namor5772/Altimeter/Images/Adaptor.png

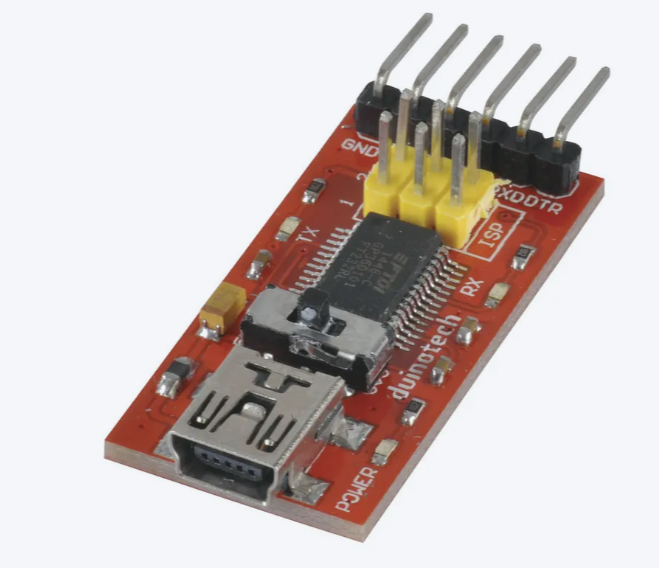
Images/Adaptor.png
