namor5772/Altimeter/Images/Case.png

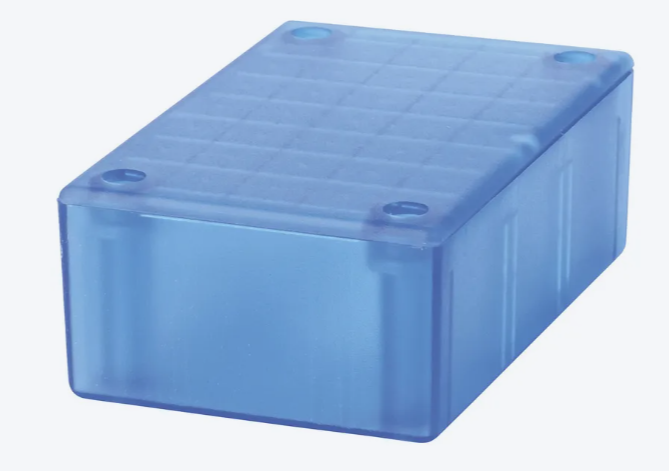
Images/Case.png
