namor5772/Altimeter/Images/Charger.png

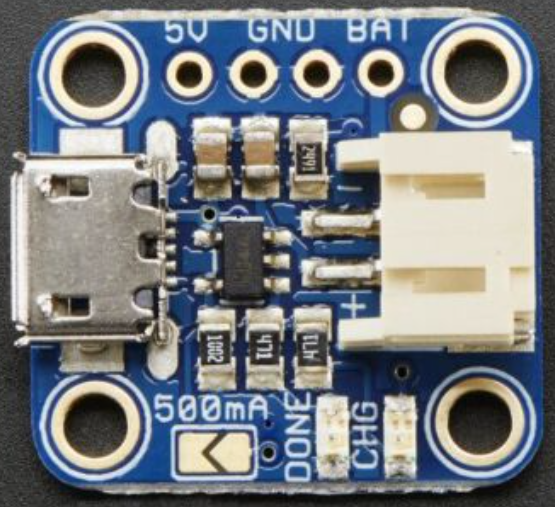
Images/Charger.png
