namor5772/Altimeter/Images/CopperWire.png

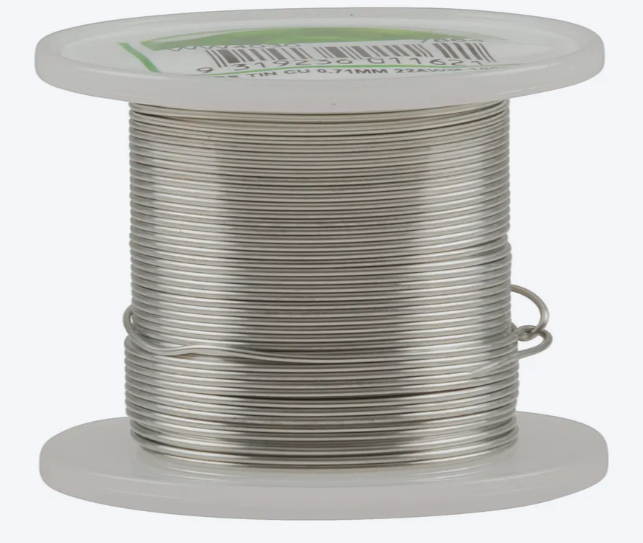
Images/CopperWire.png
