namor5772/Altimeter/Images/Display.png

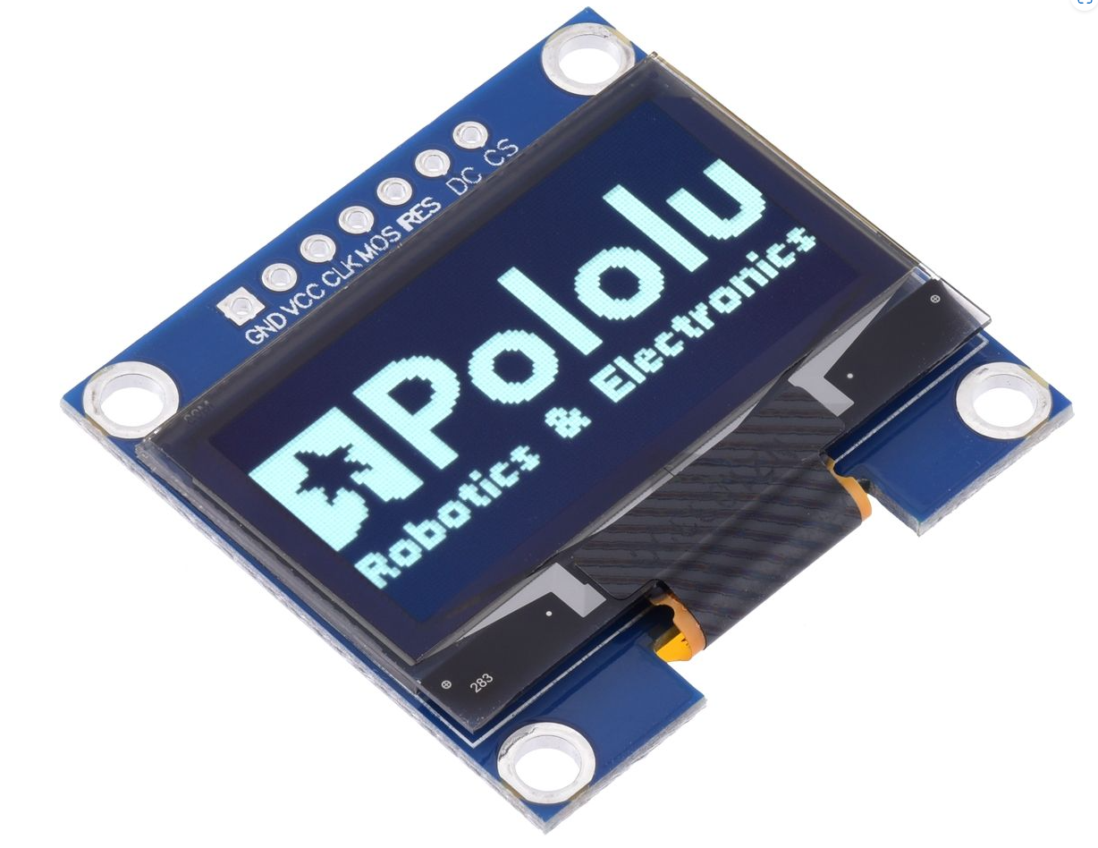
Images/Display.png
