namor5772/Altimeter/Images/FemaleStrip.png

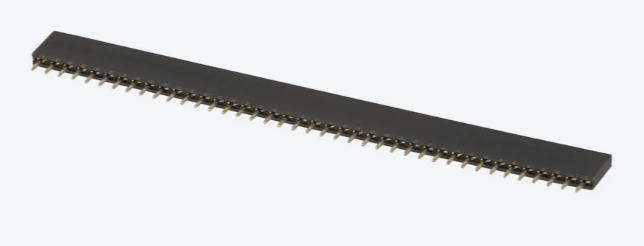
Images/FemaleStrip.png
