namor5772/Altimeter/Images/FuelGauge.png

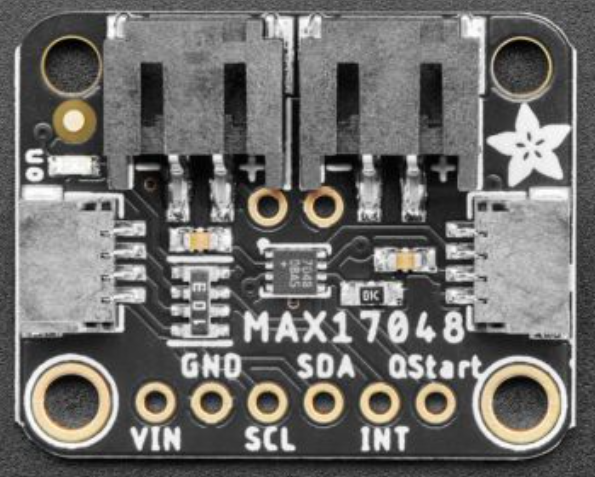
Images/FuelGauge.png
