namor5772/Altimeter/Images/image-6.png

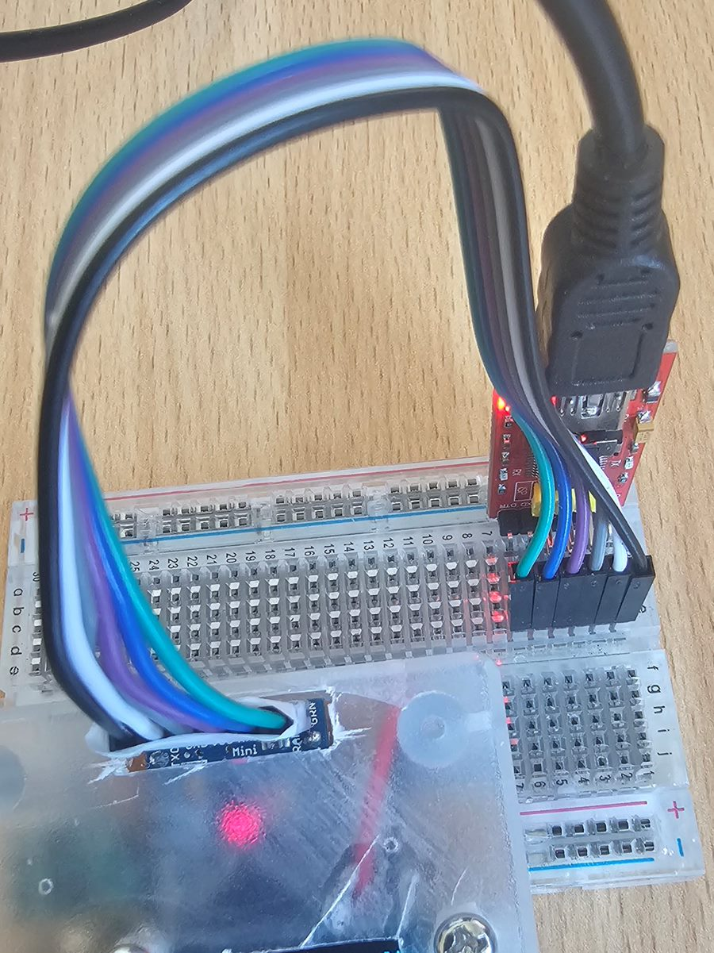
Images/image-6.png
