namor5772/Altimeter/Images/LiPoBattery.png

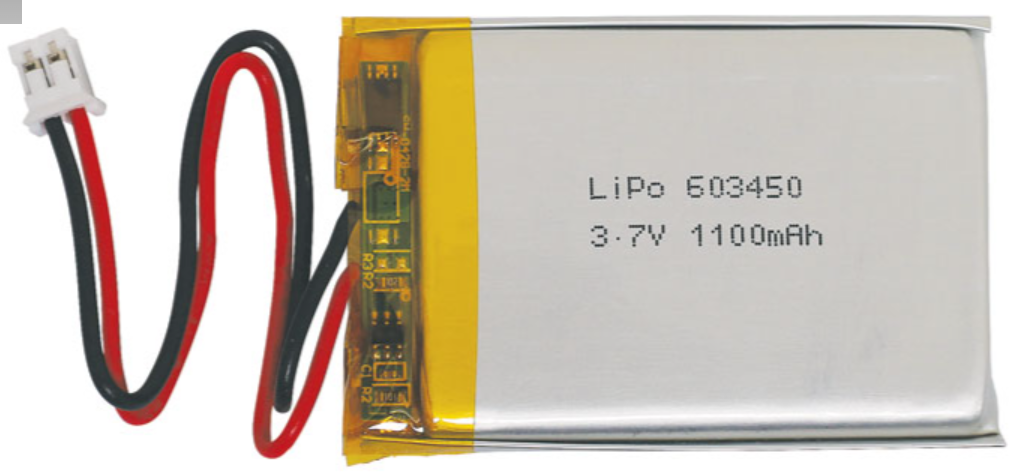
Images/LiPoBattery.png
