namor5772/Altimeter/Images/Nuts.png

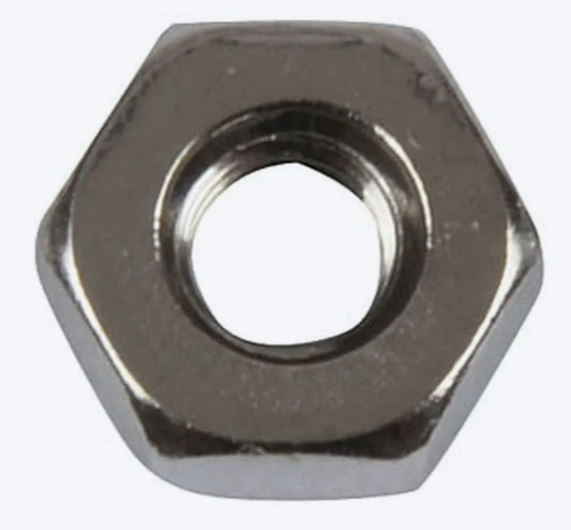
Images/Nuts.png
