namor5772/Altimeter/Images/PressureModule.png

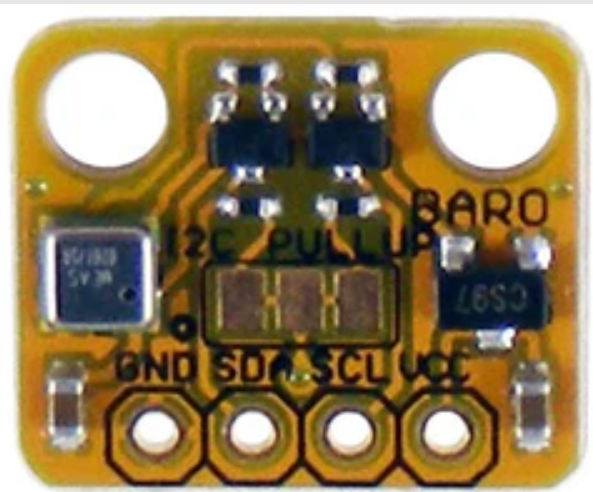
Images/PressureModule.png
