namor5772/Altimeter/Images/ProMini.png

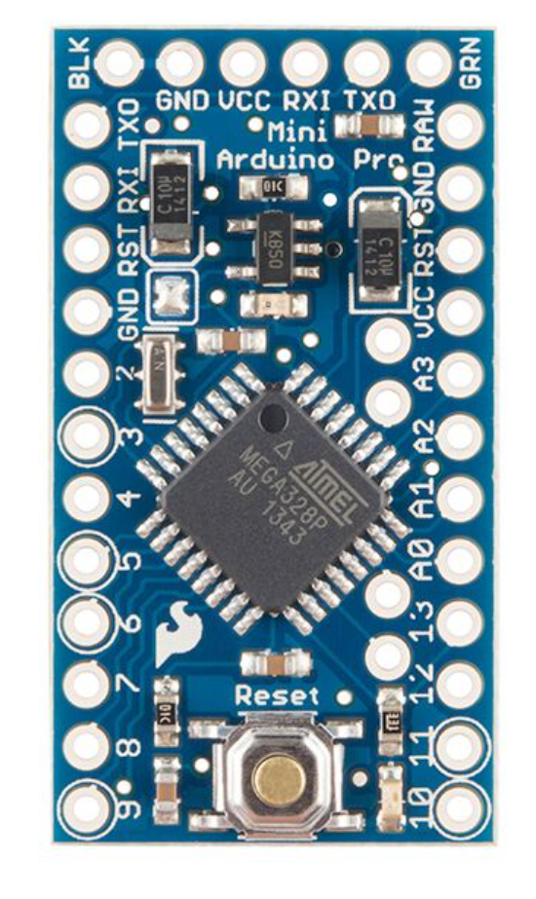
Images/ProMini.png
