namor5772/Altimeter/Images/ProMiniSchematic.png

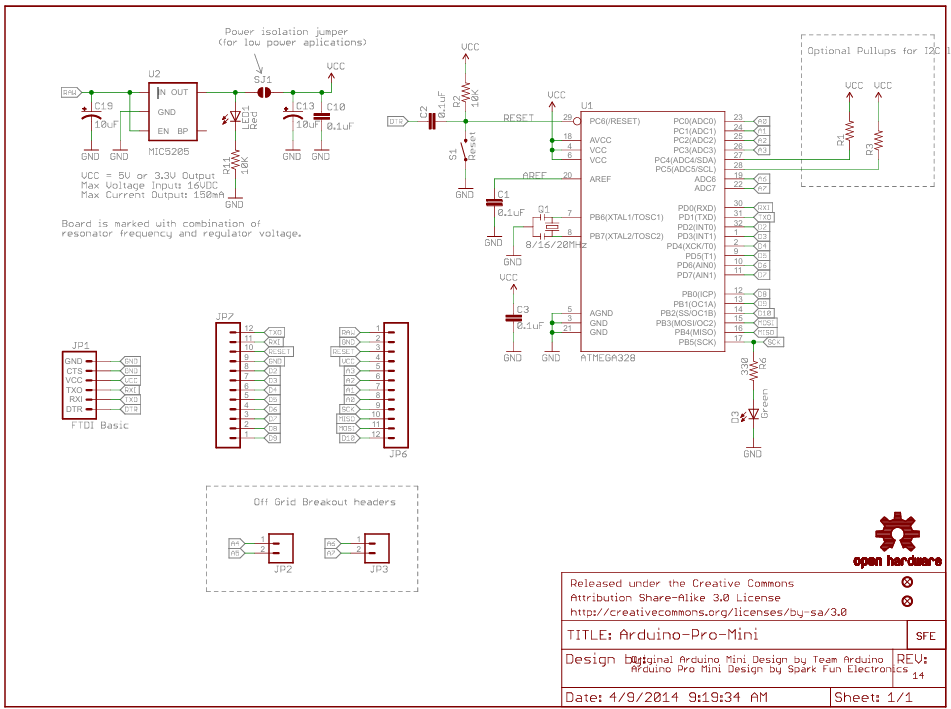
Images/ProMiniSchematic.png
