namor5772/Altimeter/Images/Screws.png

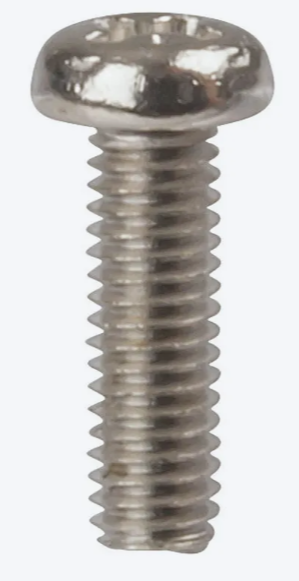
Images/Screws.png
