namor5772/Altimeter/Images/Spacers.png

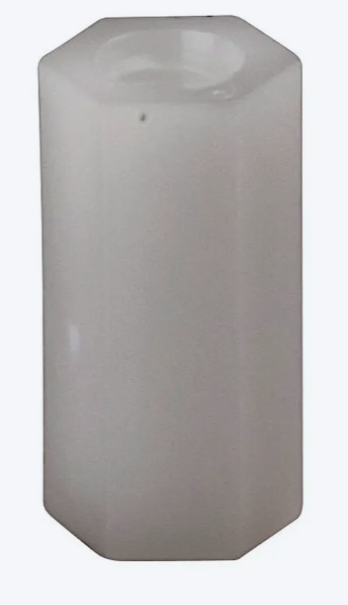
Images/Spacers.png
