namor5772/Altimeter/Images/Switch.png

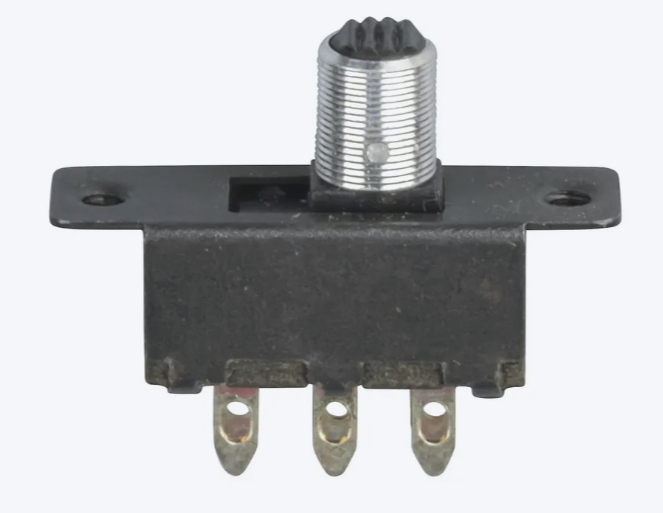
Images/Switch.png
