namor5772/Altimeter/Images/TerminalStrip.png

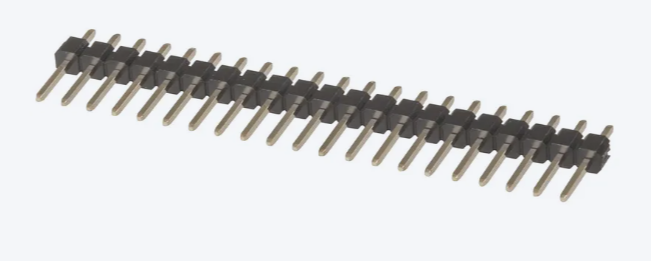
Images/TerminalStrip.png
