namor5772/Altimeter/Images/VeroBoard.png

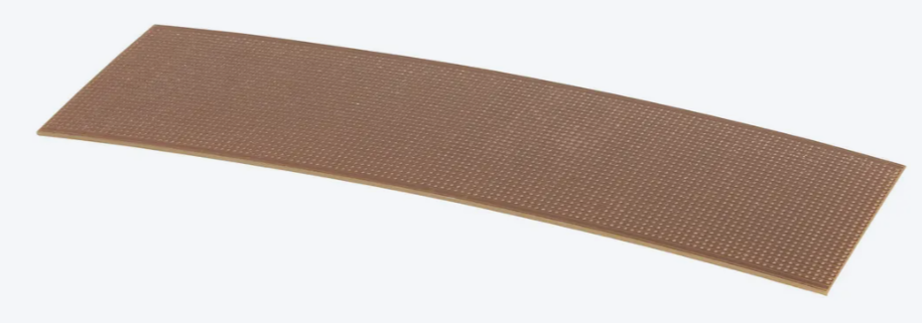
Images/VeroBoard.png
