namor5772/Altimeter/Images/VoltageRegulator.png

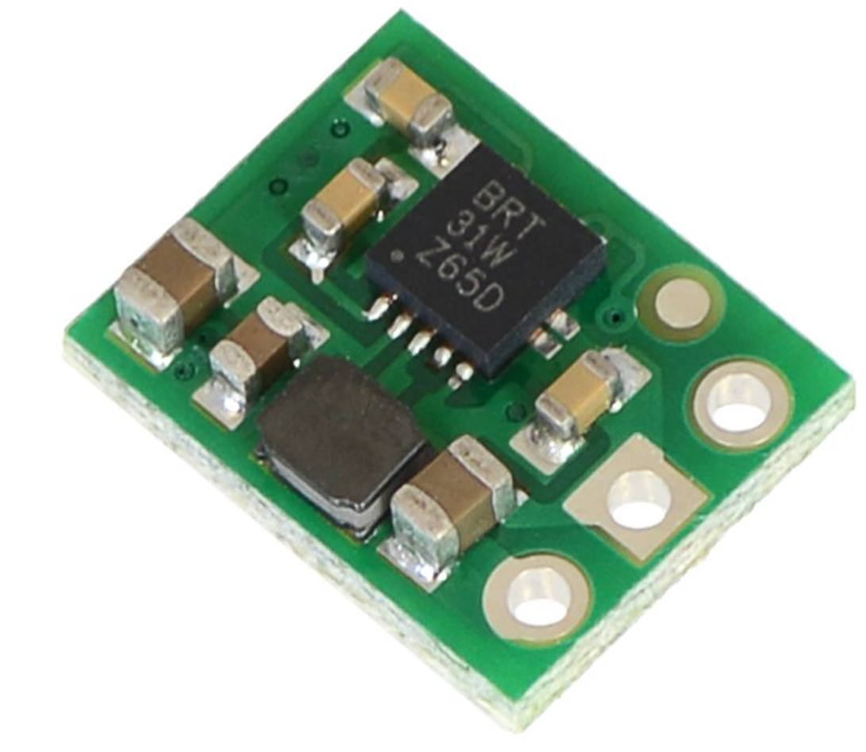
Images/VoltageRegulator.png
