namor5772/Altimeter/Images/Washers.png

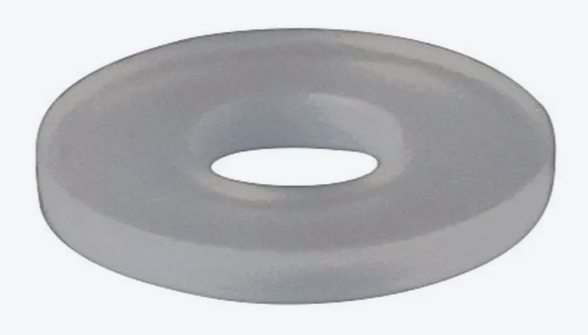
Images/Washers.png
