namor5772/Altimeter/Images/WireWhite.png

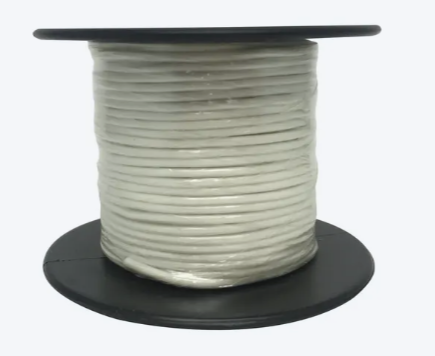
Images/WireWhite.png
