namor5772/Altimeter/Images/WireYellow.png

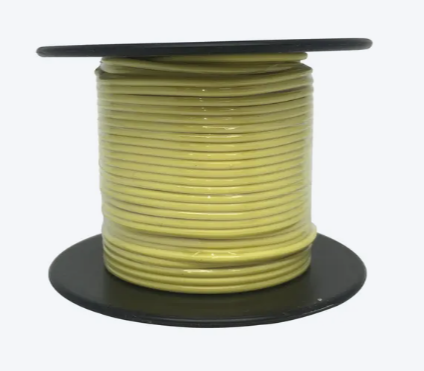
Images/WireYellow.png
