namor5772/Altimeter/(list of files, drawings)

Other design files:
Hardware/Altimeter.dsn
