namor5772/Altimeter/(commit log)

2024-10-05 Laptop 6/10/24 Binda
    [ALTIcircuit.dsn, WeatherStationMain1.dsn]
2024-10-17 Binda Desktop 17/10/24 A
    [Altimeter.dsn]
2024-10-23 Laptop 24/10/24 Binda A
    [Altimeter.dsn]
2024-10-28 Desktop 28/10/24 - C
    [ALTIcircuit.dsn, Altimeter.dsn, WeatherStationMain1.dsn]
